JoseCuretti/PIC16F887EV/switch SMD .step

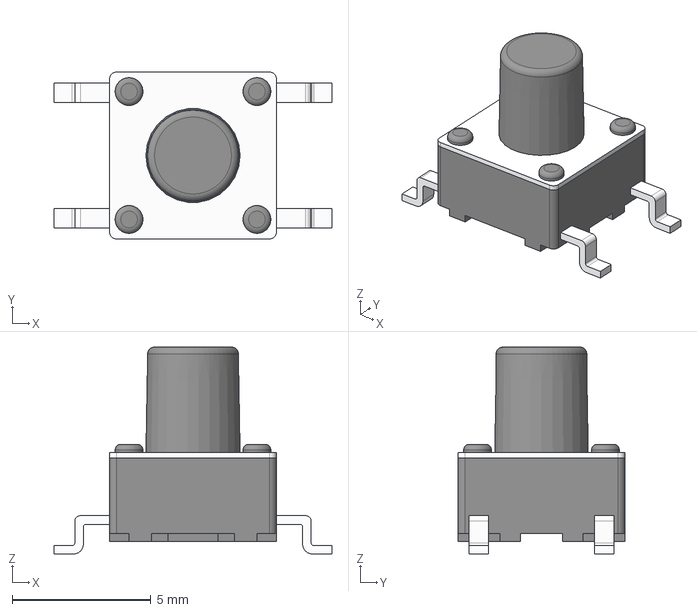
[picture p1: CAD file, 2023-11-11]
switch SMD .step
10.00 x 6.00 x 7.44 mm
