JoseCuretti/PIC16F887EV/PIC16F887EV.kicad_pcb

## KiCad design PIC16F887EV.kicad_pcb (2024-02-06)

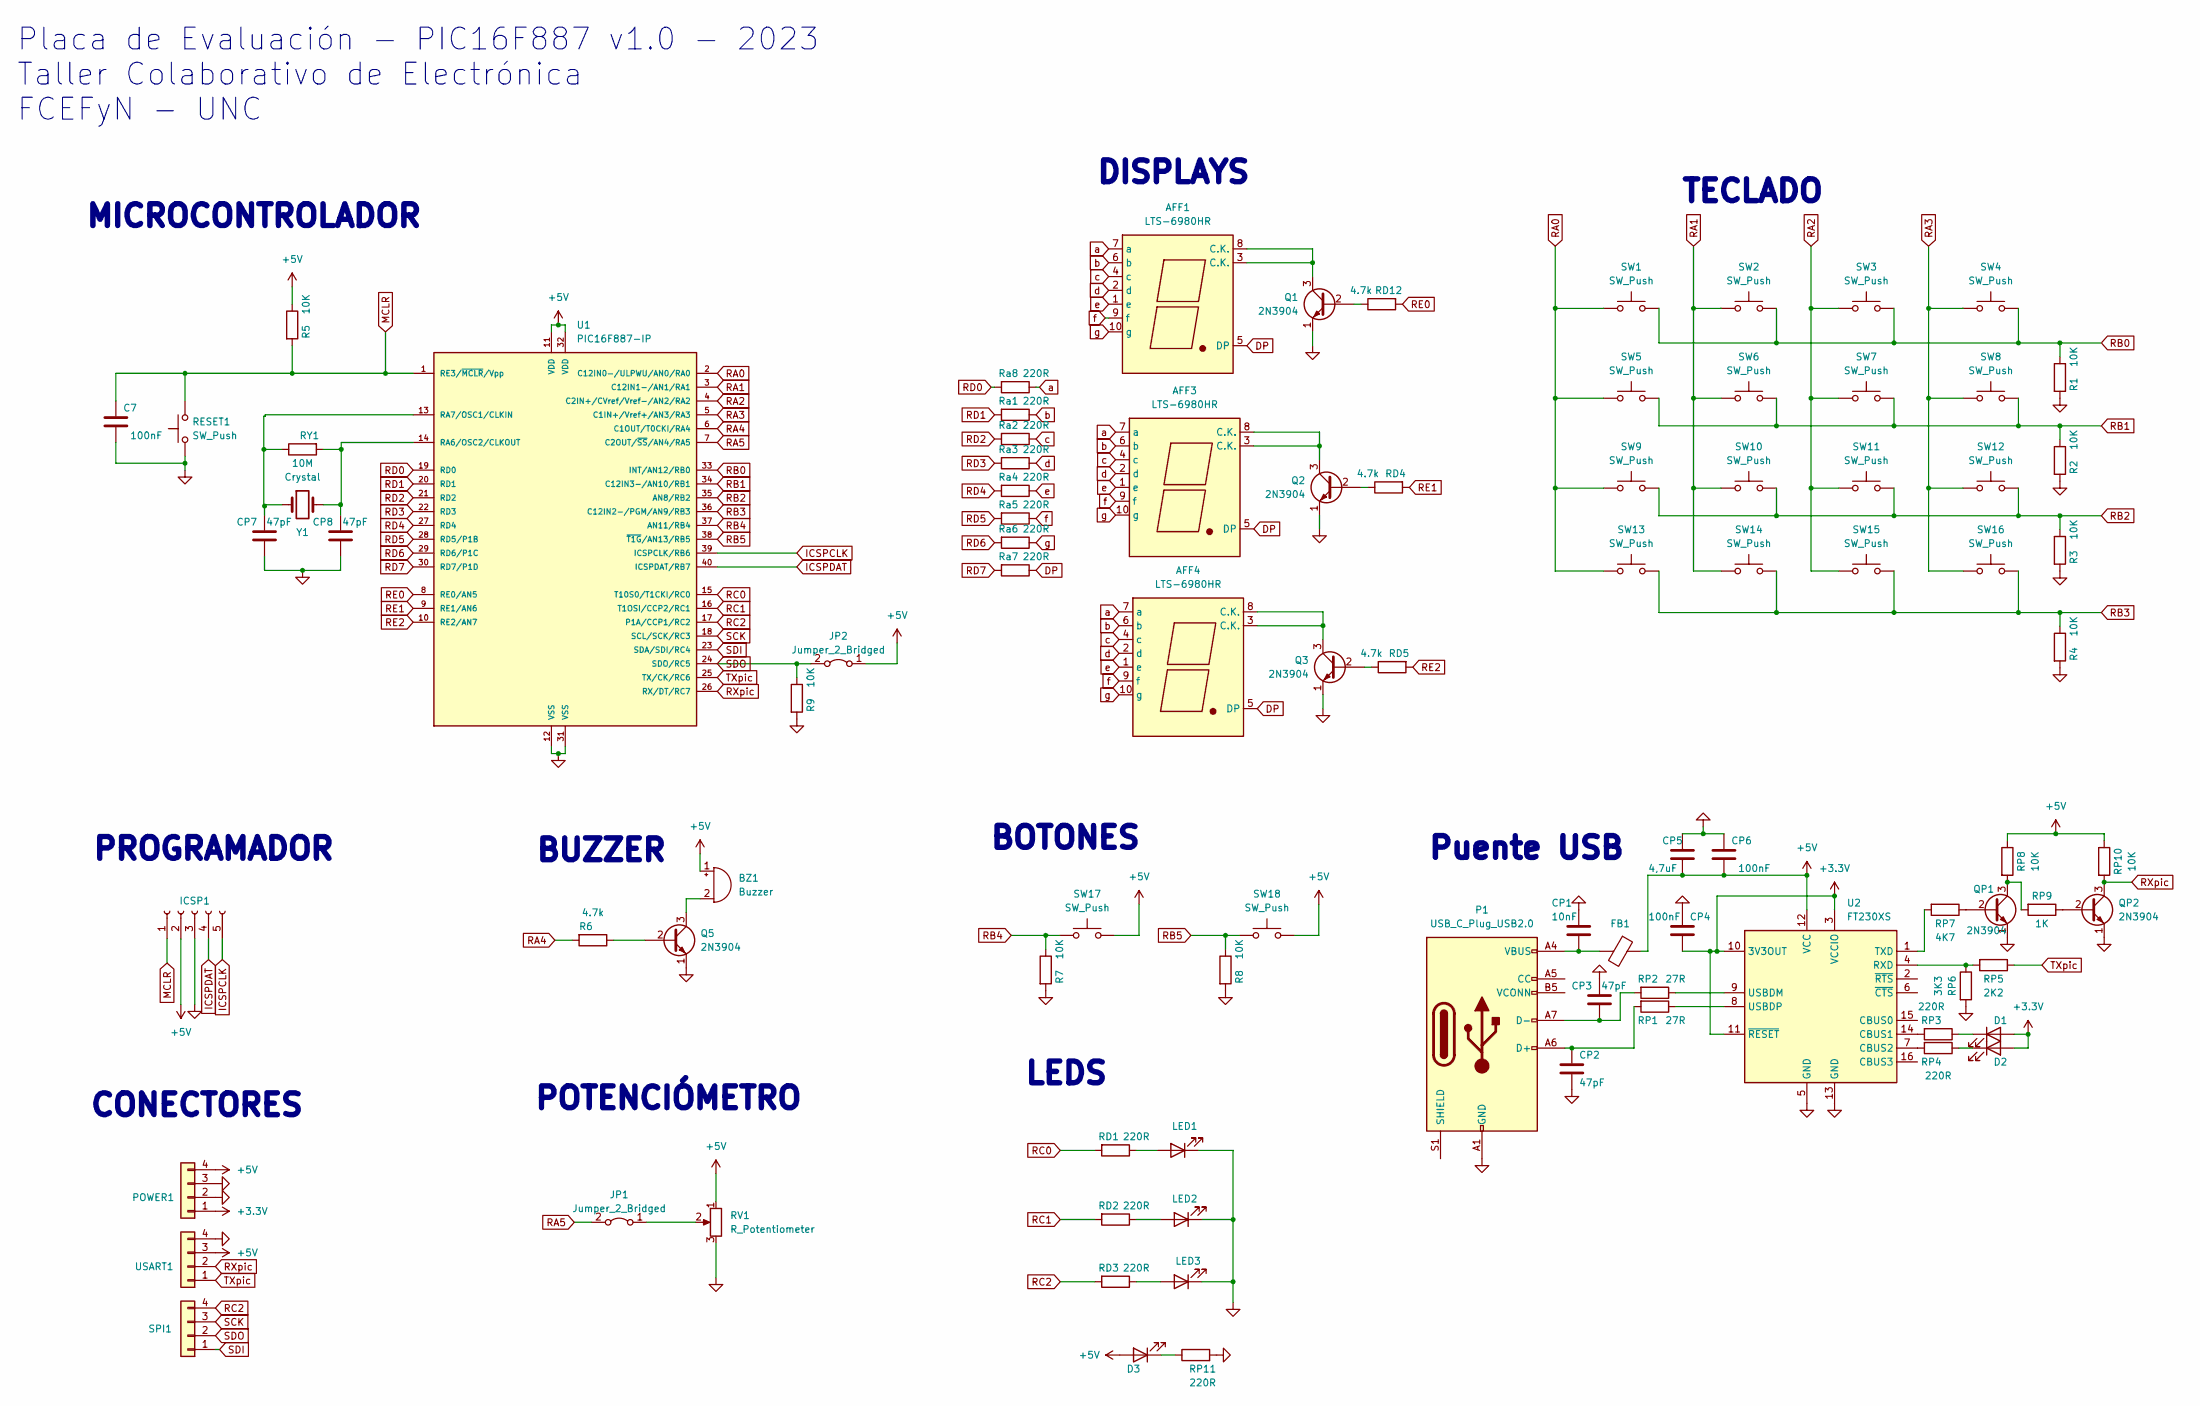
[picture p2: schematic PIC16F887EV.kicad_sch]

Parts:
AFF1, AFF3, AFF4: LTS-6980HR; 7SegmentLED_LTS6760_LTS6780
BZ1: Buzzer; MagneticBuzzer_ProSignal_ABT-410-RC
C7: 100nF; C_1206_3216Metric_Pad1.33x1.80mm_HandSolder
CP1: 10nF; C_1206_3216Metric_Pad1.33x1.80mm_HandSolder
CP2, CP3, CP7, CP8: 47pF; C_1206_3216Metric_Pad1.33x1.80mm_HandSolder
CP4, CP6: 100nF; C_1206_3216Metric_Pad1.33x1.80mm_HandSolder
CP5: 4,7uF; C_1206_3216Metric_Pad1.33x1.80mm_HandSolder
D1, D2, D3: LED; LED_1206_3216Metric_Pad1.42x1.75mm_HandSolder
FB1: FerriteBead; L_0805_2012Metric_Pad1.15x1.40mm_HandSolder
ICSP1: Conn_01x05_Socket; PinSocket_1x05_P2.54mm_Vertical
JP1, JP2: Jumper_2_Bridged; PinHeader_1x02_P2.54mm_Vertical
LED1, LED2, LED3: LED; LED_1206_3216Metric_Pad1.42x1.75mm_HandSolder
P1: USB_C_Plug_USB2.0; USB_C_Receptacle_GCT_USB4105-xx-A_16P_TopMnt_Horizontal
POWER1: Conn_01x04; PinSocket_1x04_P2.54mm_Vertical
Q1, Q2, Q3, Q5: 2N3904; SOT-23_Handsoldering
QP1, QP2: 2N3904; SOT-23_Handsoldering
R1, R2, R3, R4, R5, R7, R8, R9: 10K; R_1206_3216Metric_Pad1.30x1.75mm_HandSolder
R6: 4.7k; R_1206_3216Metric_Pad1.30x1.75mm_HandSolder
RD1, RD2, RD3: 220R; R_1206_3216Metric_Pad1.30x1.75mm_HandSolder
RD4, RD5, RD12: 4.7k; R_1206_3216Metric_Pad1.30x1.75mm_HandSolder
RESET1: SW_Push; SW_TS04-66-43-BK-100-SMT
RP1, RP2: 27R; R_1206_3216Metric_Pad1.30x1.75mm_HandSolder
RP3, RP4, RP11: 220R; R_1206_3216Metric_Pad1.30x1.75mm_HandSolder
RP5: 2K2; R_1206_3216Metric_Pad1.30x1.75mm_HandSolder
RP6: 3K3; R_1206_3216Metric_Pad1.30x1.75mm_HandSolder
RP7: 4K7; R_1206_3216Metric_Pad1.30x1.75mm_HandSolder
RP8, RP10: 10K; R_1206_3216Metric_Pad1.30x1.75mm_HandSolder
RP9: 1K; R_1206_3216Metric_Pad1.30x1.75mm_HandSolder
RV1: R_Potentiometer; Potentiometer_Bourns_3299W_Vertical
RY1: 10M; R_1206_3216Metric_Pad1.30x1.75mm_HandSolder
Ra1, Ra2, Ra3, Ra4, Ra5, Ra6, Ra7, Ra8: 220R; R_1206_3216Metric_Pad1.30x1.75mm_HandSolder
SPI1: Conn_01x04; PinSocket_1x04_P2.54mm_Vertical
SW1, SW2, SW3, SW4, SW5, SW6, SW7, SW8, SW9, SW10, SW11, SW12, SW13, SW14, SW15, SW16, SW17, SW18: SW_Push; SW_TS04-66-43-BK-100-SMT
U1: PIC16F887-IP; DIP-40_W15.24mm_LongPads
U2: FT230XS; SSOP-16_3.9x4.9mm_P0.635mm
USART1: Conn_01x04; PinSocket_1x04_P2.54mm_Vertical
Y1: Crystal; Crystal_HC18-U_Vertical

Connections:
+3.3V: CP4.2, D1.2 (A), D2.2 (A), POWER1.1, U2.3 (VCCIO), U2.10 (3V3OUT), U2.11 (~RESET)
+5V: BZ1.1 (-), CP5.2, CP6.2, D3.2 (A), FB1.1, ICSP1.2, JP2.1 (A), POWER1.4, R5.1, RP8.1, RP10.1, RV1.1, SW17.2, SW18.2, U1.11 (VDD), U1.32 (VDD), U2.12 (VCC), USART1.3
DP: AFF1.5 (DP), AFF3.5 (DP), AFF4.5 (DP), Ra7.1
GND: C7.2, CP1.1, CP2.2, CP3.2, CP4.1, CP5.1, CP6.1, CP7.1, CP8.1, ICSP1.3, LED1.1 (K), LED2.1 (K), LED3.1 (K), P1.A1 (GND), P1.A12 (GND), P1.B1 (GND), P1.B12 (GND), POWER1.2, POWER1.3, Q1.1 (E), Q2.1 (E), Q3.1 (E), Q5.1 (E), QP1.1 (E), QP2.1 (E), R1.2, R2.2, R3.2, R4.2, R7.2, R8.2, R9.2, RESET1.1, RP6.2, RP11.2, RV1.3, U1.12 (VSS), U1.31 (VSS), U2.5 (GND), U2.13 (GND), USART1.4
ICSPCLK: ICSP1.5, U1.39 (ICSPCLK/RB6)
ICSPDAT: ICSP1.4, U1.40 (ICSPDAT/RB7)
MCLR: C7.1, ICSP1.1, R5.2, RESET1.2, U1.1 (RE3/~MCLR/Vpp)
unnamed: BZ1.2 (+), Q5.3 (C)
unnamed: CP1.2, FB1.2, P1.A4 (VBUS), P1.A9 (VBUS), P1.B4 (VBUS), P1.B9 (VBUS)
unnamed: D1.1 (K), RP3.1
unnamed: D2.1 (K), RP4.1
unnamed: D3.1 (K), RP11.1
unnamed: JP1.1 (A), RV1.2
unnamed: LED1.2 (A), RD1.1
unnamed: LED2.2 (A), RD2.1
unnamed: LED3.2 (A), RD3.1
unnamed: CP2.1, P1.A6 (D+), RP1.2
unnamed: CP3.1, P1.A7 (D-), RP2.2
unnamed: Q1.2 (B), RD12.1
unnamed: AFF1.3 (C.K.), AFF1.8 (C.K.), Q1.3 (C)
unnamed: Q2.2 (B), RD4.1
unnamed: AFF3.3 (C.K.), AFF3.8 (C.K.), Q2.3 (C)
unnamed: Q3.2 (B), RD5.1
unnamed: AFF4.3 (C.K.), AFF4.8 (C.K.), Q3.3 (C)
unnamed: Q5.2 (B), R6.1
unnamed: QP1.2 (B), RP7.1
unnamed: QP1.3 (C), RP8.2, RP9.2
unnamed: QP2.2 (B), RP9.1
unnamed: CP8.2, RY1.2, U1.14 (RA6/OSC2/CLKOUT), Y1.2
unnamed: CP7.2, RY1.1, U1.13 (RA7/OSC1/CLKIN), Y1.1
unnamed: RP3.2, U2.14 (CBUS1)
unnamed: RP4.2, U2.7 (CBUS2)
unnamed: RP5.2, RP6.1, U2.4 (RXD)
unnamed: RP7.2, U2.1 (TXD)
unnamed: RP2.1, U2.9 (USBDM)
unnamed: RP1.1, U2.8 (USBDP)
RA0: SW1.1, SW5.1, SW9.1, SW13.1, U1.2 (C12IN0-/ULPWU/AN0/RA0)
RA1: SW2.1, SW6.1, SW10.1, SW14.1, U1.3 (C12IN1-/AN1/RA1)
RA2: SW3.1, SW7.1, SW11.1, SW15.1, U1.4 (C2IN+/CVref/Vref-/AN2/RA2)
RA3: SW4.1, SW8.1, SW12.1, SW16.1, U1.5 (C1IN+/Vref+/AN3/RA3)
RA4: R6.2, U1.6 (C1OUT/T0CKI/RA4)
RA5: JP1.2 (B), U1.7 (C2OUT/~SS/AN4/RA5)
RB0: R1.1, SW1.2, SW2.2, SW3.2, SW4.2, U1.33 (INT/AN12/RB0)
RB1: R2.1, SW5.2, SW6.2, SW7.2, SW8.2, U1.34 (C12IN3-/AN10/RB1)
RB2: R3.1, SW9.2, SW10.2, SW11.2, SW12.2, U1.35 (AN8/RB2)
RB3: R4.1, SW13.2, SW14.2, SW15.2, SW16.2, U1.36 (C12IN2-/PGM/AN9/RB3)
RB4: R7.1, SW17.1, U1.37 (AN11/RB4)
RB5: R8.1, SW18.1, U1.38 (~T1G/AN13/RB5)
RC0: RD1.2, U1.15 (T10S0/T1CKI/RC0)
RC1: RD2.2, U1.16 (T1OSI/CCP2/RC1)
RC2: RD3.2, SPI1.4, U1.17 (P1A/CCP1/RC2)
RD0: Ra8.2, U1.19 (RD0)
RD1: Ra1.2, U1.20 (RD1)
RD2: Ra2.2, U1.21 (RD2)
RD3: Ra3.2, U1.22 (RD3)
RD4: Ra4.2, U1.27 (RD4)
RD5: Ra5.2, U1.28 (RD5/P1B)
RD6: Ra6.2, U1.29 (RD6/P1C)
RD7: Ra7.2, U1.30 (RD7/P1D)
RE0: RD12.2, U1.8 (RE0/AN5)
RE1: RD4.2, U1.9 (RE1/AN6)
RE2: RD5.2, U1.10 (RE2/AN7)
RXpic: QP2.3 (C), RP10.2, U1.26 (RX/DT/RC7), USART1.2
SCK: SPI1.3, U1.18 (SCL/SCK/RC3)
SDI: SPI1.1, U1.23 (SDA/SDI/RC4)
SDO: JP2.2 (B), R9.1, SPI1.2, U1.24 (SDO/RC5)
TXpic: RP5.1, U1.25 (TX/CK/RC6), USART1.1
a: AFF1.7 (a), AFF3.7 (a), AFF4.7 (a), Ra8.1
b: AFF1.6 (b), AFF3.6 (b), AFF4.6 (b), Ra1.1
c: AFF1.4 (c), AFF3.4 (c), AFF4.4 (c), Ra2.1
d: AFF1.2 (d), AFF3.2 (d), AFF4.2 (d), Ra3.1
e: AFF1.1 (e), AFF3.1 (e), AFF4.1 (e), Ra4.1
f: AFF1.9 (f), AFF3.9 (f), AFF4.9 (f), Ra5.1
g: AFF1.10 (g), AFF3.10 (g), AFF4.10 (g), Ra6.1

Notes on the sheet:
BUZZER
MICROCONTROLADOR
Placa de Evaluación - PIC16F887 v1.0 - 2023 Taller Colaborativo de Electrónica FCEFyN - UNC
CONECTORES
LEDS
BOTONES
PROGRAMADOR
TECLADO
DISPLAYS
Puente USB
POTENCIÓMETRO

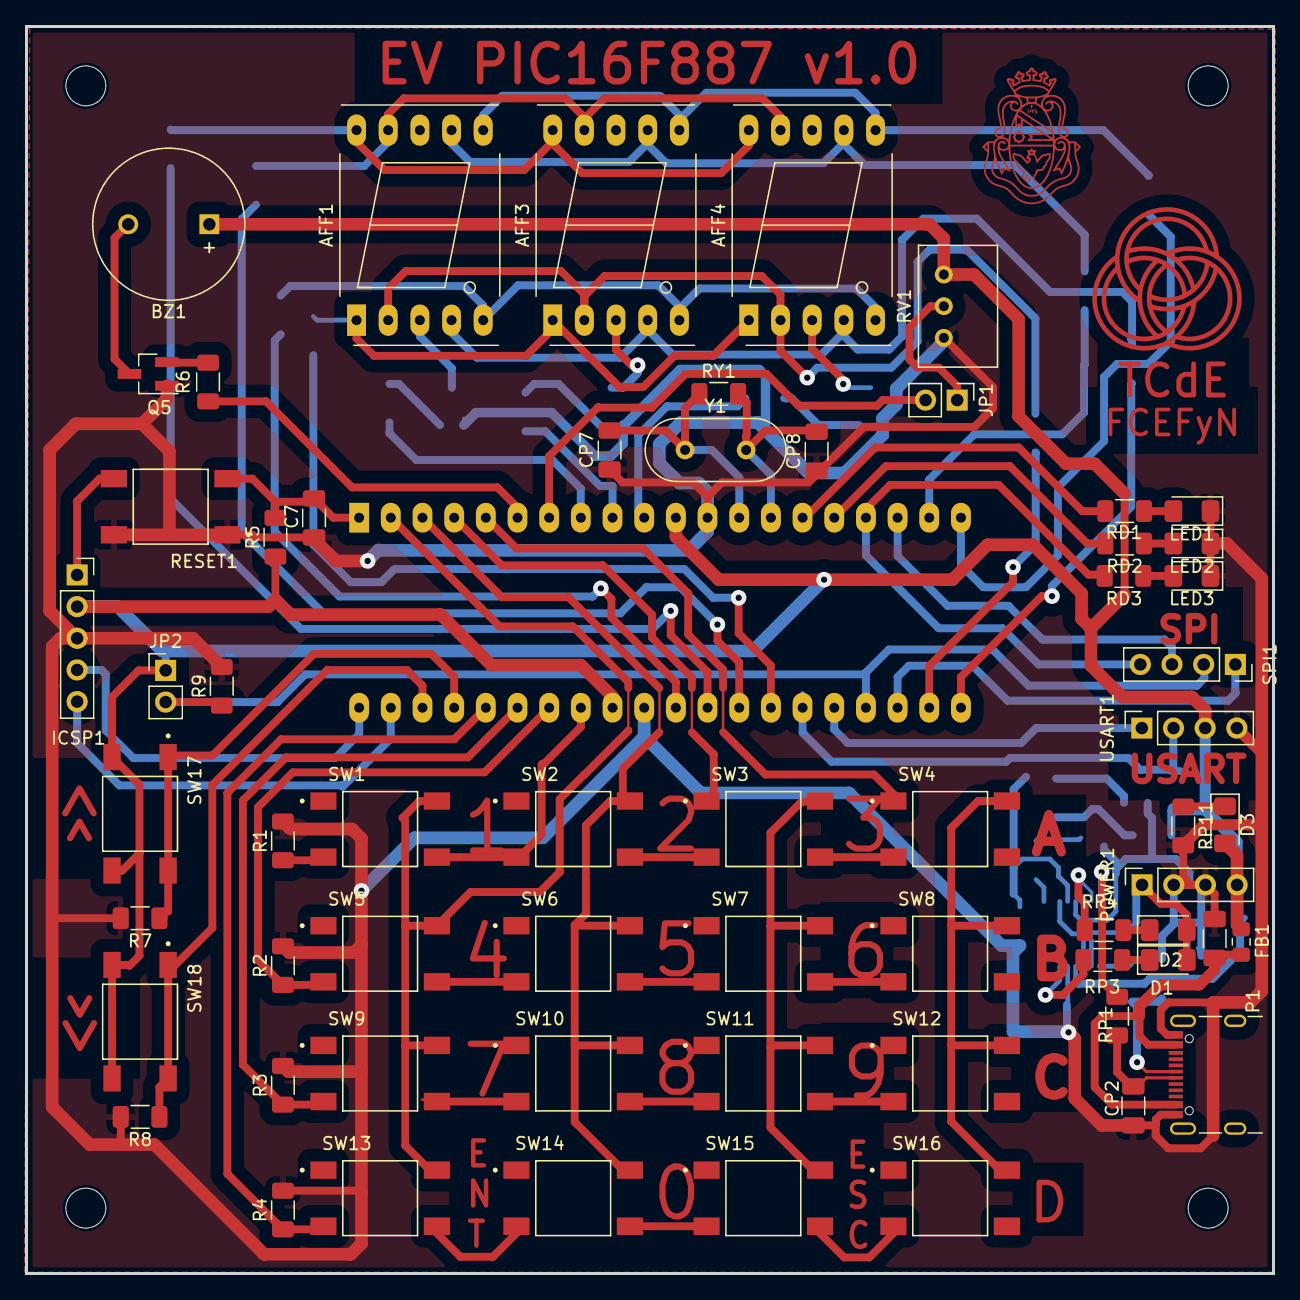
[picture p3: board PIC16F887EV.kicad_pcb from above]

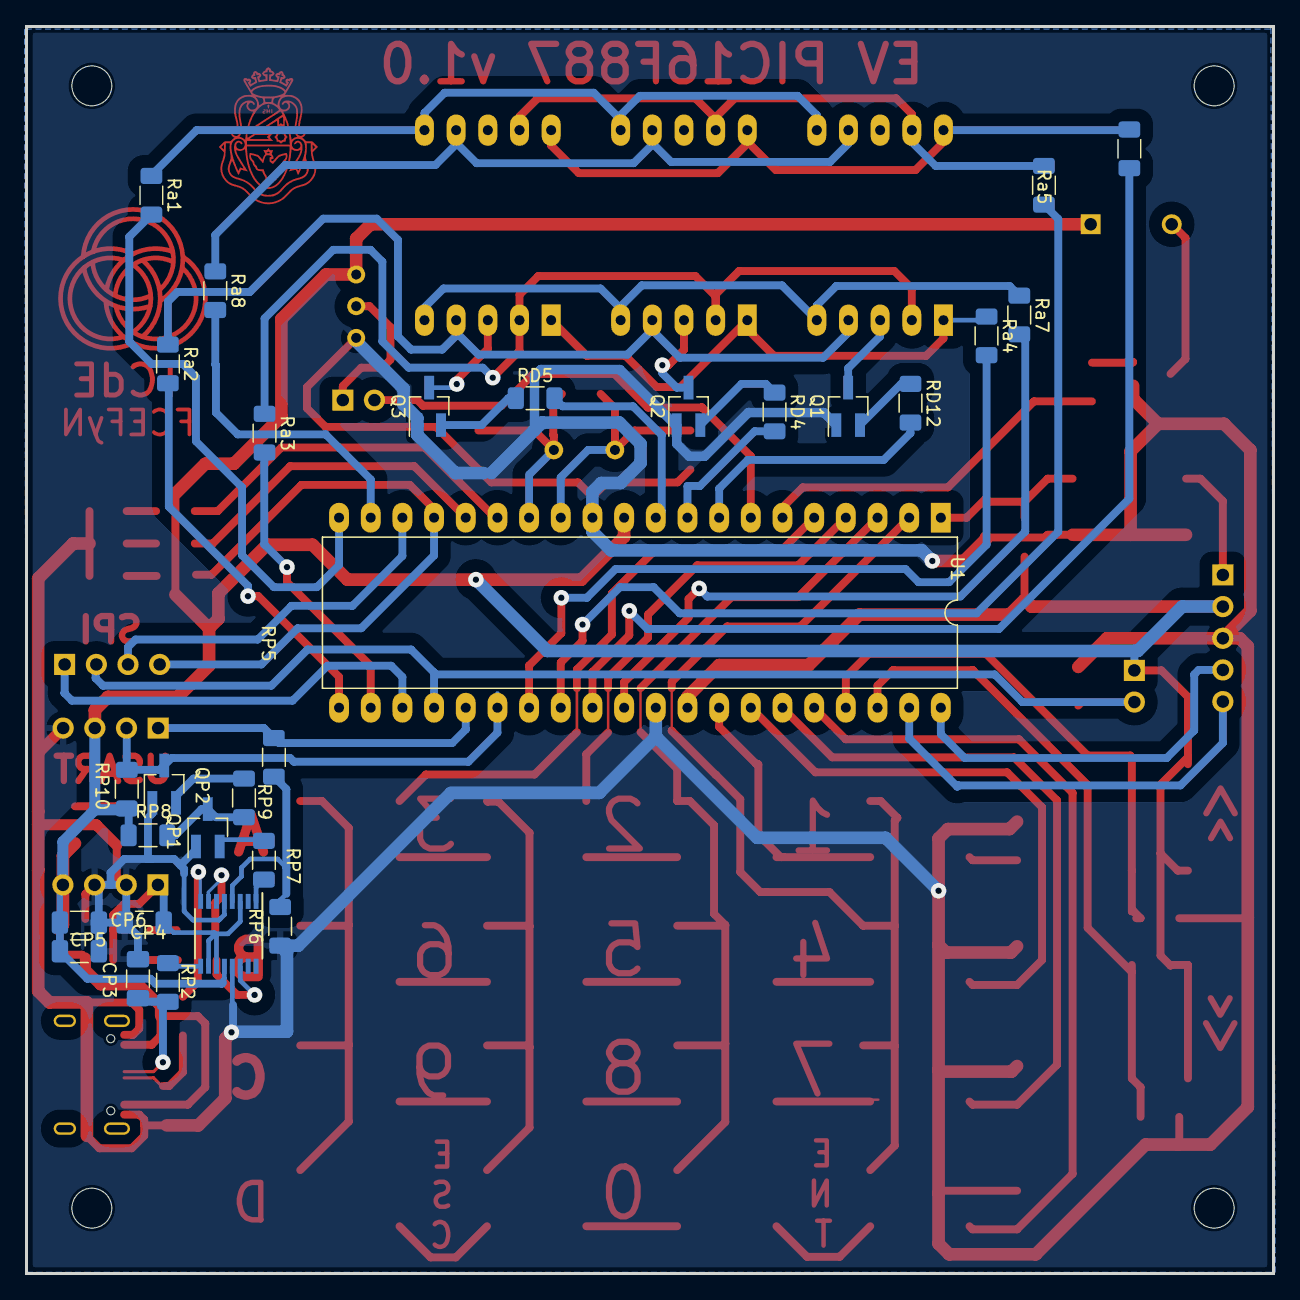
[picture p4: board PIC16F887EV.kicad_pcb from below]

Board: 2 copper layers, 100.0 x 100.0 mm, 97 parts (29 on the bottom side), 74 nets.

Other parts of the board:
REF1, REF2, REF3, REF4: MountingHole_3.2mm_M3
TCdE FCEFYN: Logo
TCdE FCEFYN#2: Logo
