JoseCuretti/PIC16F887EV/(commit log)

2023-09-24 Add files via upload
    Commit inicial
    [PIC16F887EV.kicad_pcb, PIC16F887EV.kicad_sch]
2023-09-29 Add files via upload
    con corto prueba
    [PIC16F887EV.kicad_sch]
2023-10-06 Buzzer Agregado
    Hay que elegir el footprint correcto
    [PIC16F887EV.kicad_sch]
2023-10-06 Add files via upload
    Esquemático basado en proyecto de Digital 2
    [Placa de Desarrollo PIC-16F887 SMD.kicad_sch]
2023-10-06 cambio de pin a n 7
    [PIC16F887EV.kicad_sch]
2023-10-06 cambio a pin 23
    [PIC16F887EV.kicad_sch]
2023-10-12 USB-C y FT230X
    Agregado Puente USB y conector USB-C
    [PIC16F887EV.kicad_pcb, PIC16F887EV.kicad_sch]
2023-10-12 Keypad
    Teclado 4x4 sin pull ups externas
    [PIC16F887EV.kicad_sch]
2023-10-12 display SA56-11SRWA
    [PIC16F887EV.kicad_pcb, PIC16F887EV.kicad_sch]
2023-10-14 SW1 Huella
    Cambio Botón SW1, ahora con huella
    [PIC16F887EV.kicad_pcb, PIC16F887EV.kicad_sch]
2023-10-16 Puente USB completo
    Agregué y conecté todos los componentes del Puente USB-USART en el esquemático
    [PIC16F887EV.kicad_pcb, PIC16F887EV.kicad_sch]
2023-10-19 Actualización teclado
    [PIC16F887EV.kicad_pcb, PIC16F887EV.kicad_sch]
2023-10-19 Avance parcial
    Leds + Potenciómetro + ICSP
    [PIC16F887EV.kicad_sch]
2023-10-19 Leds smd 1206
    [PIC16F887EV.kicad_sch]
2023-10-19 Corrección leds
    [PIC16F887EV.kicad_pcb, PIC16F887EV.kicad_sch]
2023-10-19 Socket ICSP
    [PIC16F887EV.kicad_pcb, PIC16F887EV.kicad_sch]
2023-10-19 Actualización
    [PIC16F887EV.kicad_pcb, PIC16F887EV.kicad_sch]
2023-10-20 Actualizacion Puente + Huellas
    Agregue componentes de interfaz entre PIC (5V) y puente USB (3V3).
    Cambie las huellas de transistores a SMD.
    Cambie el BJT 2N2222 por un 3904
    [PIC16F887EV.kicad_pcb, PIC16F887EV.kicad_sch]
2023-10-21 LimitesPCB+Reglas
    Agregado el cuadrado de 10cmx10cm y algunas reglas de enrutamiento
    [PIC16F887EV.kicad_pcb]
2023-10-22 Avance esquemático
    Cristal externo + Teclado en puertos A y B con pulldown + huella potenciometro + pin de programación
    [PIC16F887EV.kicad_pcb, PIC16F887EV.kicad_sch]
2023-10-24 Distribución de componentes dentro del rectángulo de 10x10cm
    Moví los componentes y los agrupé aproximadamente donde podrían ir dejando el PIC y el puente USB del lado inferior.
    A los switchs de teclado les cambié la huella por una con modelo 3d pero del mismo footprint
    [PIC16F887EV.kicad_pcb, PIC16F887EV.kicad_sch]
2023-10-24 Tornillos + Huella Potenciometro
    Agregado de 4 huecos para tornillos de montaje
    Cambio de huella del potenciómetro
    [PIC16F887EV.kicad_pcb, PIC16F887EV.kicad_sch]
2023-10-25 Ruteo provisorio capa frontal
    [PIC16F887EV.kicad_pcb, PIC16F887EV.kicad_sch]
2023-10-25 Logo
    Logo Taller Colaborativo de Electronica + Nombre de placa
    [PIC16F887EV.kicad_pcb]
2023-10-25 Jumpers modificados
    tuve que cambiar la ubicación de uno porque estaba sobre el PIC
    [PIC16F887EV.kicad_pcb, PIC16F887EV.kicad_sch]
2023-10-25 unc logo
    agregue un mini logo de unc
    [PIC16F887EV.kicad_pcb]
2023-10-26 Texto y espaciado de teclado - jumper desplazado
    * Agregue texto en el formato de 4x4, espesor 0.5 . --> Puede cambiarse, opte por ese formado por el teclado matricial comercial.
    * Moví el jumper ,ya que se encontraba muy cerca del teclado y podría ser incomodo presionar.
    * Conexiones comunes como +5v o GND en el PIC las desconecte para tener mas rutas en el ruteo (estas están conectadas internamente en el PIC)
    * Conexión entre patas comunes en los pulsadores también las borre, sé que son comunes de a par, podría no tener sentido unirlas, ya que internamente lo están. (igual
    es opcional, se puede volver a agregar)
    * Opte por poner en un lateral las letras del teclado ya que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
    [PIC16F887EV.kicad_pcb]
2023-10-26 Bloque displays con vías
    [PIC16F887EV.kicad_pcb]
2023-10-26 Teclado
    Fer hace un rato pifíe con el teclado! acabo de volverlo a rutear más o menos como lo habías ruteado vos, chequealo y cambialo cualquier cosa!
    [PIC16F887EV.kicad_pcb]
2023-10-26 Buzzer y Jumper para Pickit
    Ruteo del buzzer y ajuste de espacio para ver si entran los displays en la parte de arriba.
    A los 3 displays los dejé mas o menos acomodados a un costado para después ponerlos en la placa y conectar al pic por la capa trasera.
    [PIC16F887EV.kicad_pcb]
2023-10-27 Ubicación de Displays
    Me están quedando pendientes las 8 Res de cada segmento
    [PIC16F887EV.kicad_pcb]
2023-10-27 Conectores + Etiquetas Teclas
    Agregado de conectores de USART SPI y POWER
    Rescate de los números y letras de las teclas, con modificación del * y #
    [PIC16F887EV.kicad_pcb, PIC16F887EV.kicad_sch]
2023-10-27 Puente USB ruteado
    [PIC16F887EV.kicad_pcb, PIC16F887EV.kicad_sch]
2023-10-30 agrego + tamaños de logos unc
    [PIC16F887EV.kicad_pcb]
2023-10-31 USB completo
    Termine la parte de USB y conectores
    [PIC16F887EV.kicad_pcb, PIC16F887EV.kicad_sch]
2023-11-01 agrego mas tamaños de logos
    [PIC16F887EV.kicad_pcb]
2023-11-01 Logo tamaño 2
    [PIC16F887EV.kicad_pcb]
2023-11-03 Ruteo de GND y resistencias de los displays.
    [PIC16F887EV.kicad_pcb]
2023-11-03 Agregado de Texto a teclados y simbolo a Pulsador
    Al texto y símbolos los agrupe, para ambos caso sobre la capa F.Cu le puse una F.Mask. Asi el cobre esta al frente.
    [PIC16F887EV.kicad_pcb]
2023-11-03 Agregado de F.Mask a logos
    se quito el rectángulo de F.Mask de los logos y se superpuso el mismo logo con otra capa, así queda descubierto el cobre sobre el mismo.
    [PIC16F887EV.kicad_pcb]
2023-11-05 Displays ruteados
    Falta la conexión de las pistas de 5V que están en distintas capas
    [PIC16F887EV.kicad_pcb]
2023-11-05 Version Final 1.0
    Algunos footprint cambiados, repaso de ancho de pistas y tamaño de vias, agregado de plano de masa
    [PIC16F887EV.kicad_pcb, PIC16F887EV.kicad_sch]
2023-11-11 Modelo 3D para los nuenos switches
    asigné el modelo del switch al footprint del primer botón del teclado. El diseño está en la carpeta del proyecto como un .step no pude asignar el modelo a todos los botones al mismo tiempo, si alguien lo logra se agradece, sino por supuesto se puede hacer uno por uno
    [PIC16F887EV.kicad_pcb, switch SMD .step]
2023-11-16 Modelo 3D para los interruptores
    Ya tienen su modelo los interruptores, no logré hacerlo con el script y lo hice un poco a mano modificando el archivo del PCB desde el bloc de notas.
    Fue al menos más rápido que asignando una por una desde el KiCAD
    [PIC16F887EV.kicad_pcb]
2024-01-22 Programa Prueba Hardware
    .c y .hex de programa que prueba LEDS, DISPLAYS, BUZZER, Teclas y USART
    [PruebaHardwarePIC16F887EV.c]
2024-02-06 Acomodo SCH
    Acomodo un poco los modulos del esquematico
    [PIC16F887EV.kicad_sch]
2024-02-06 Valores PCB acomodados
    Acomodo los nombres y valores de los componentes
    [PIC16F887EV.kicad_pcb]
